jp112sdl/HB-UNI-Sen-PH-ORP/README.md

# HB-UNI-Sen-PH-ORP

universeller HomeMatic PH- + ORP-Sensor

#### Bauteile:

- Arduino Pro Mini (3.3V / 8MHz)
- CC1101 868MHz Funkmodul 
- PH Sensor https://www.dfrobot.com/product-1782.html
- ORP Sensor https://www.dfrobot.com/product-1071.html
- I2C LCD Display 2x16 
- DS18B20 Temperatursensor
- Widerstände: 240 Ohm, 4,7k

#### Schaltungsübersicht

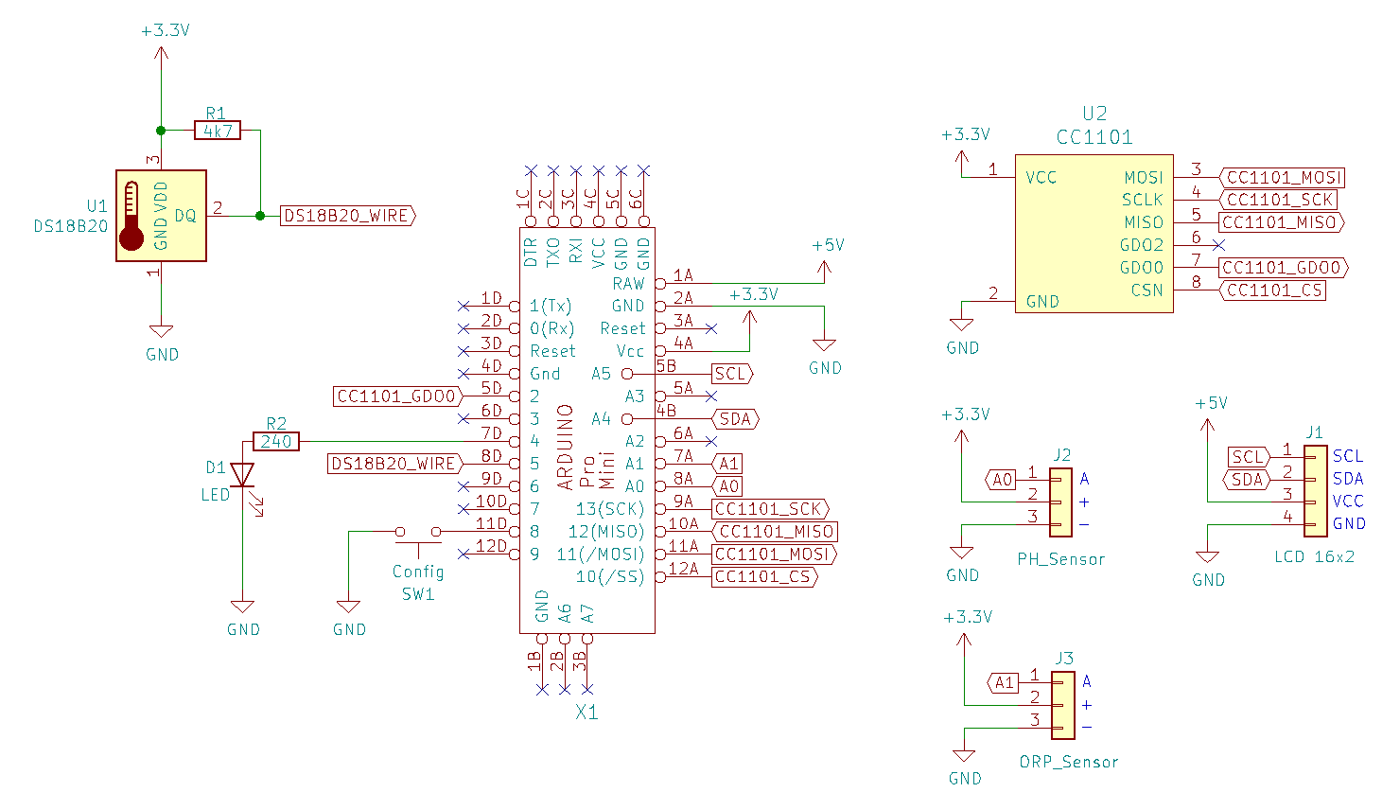
[picture p1: Images/schematics.png]
schematics


#### CCU Status und Bedienung

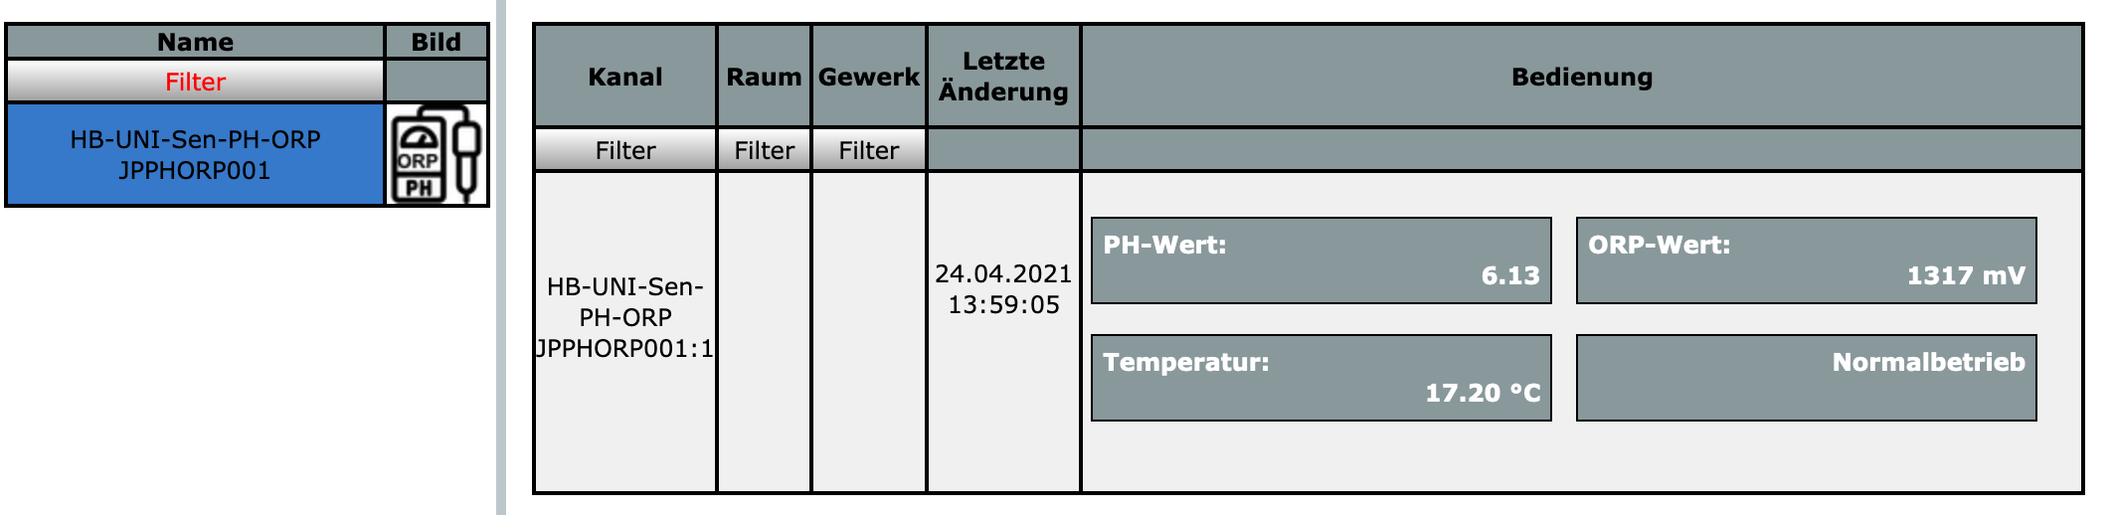
[picture p2: Images/ccu_bedienung.png]
bedienung


#### CCU Einstellungen

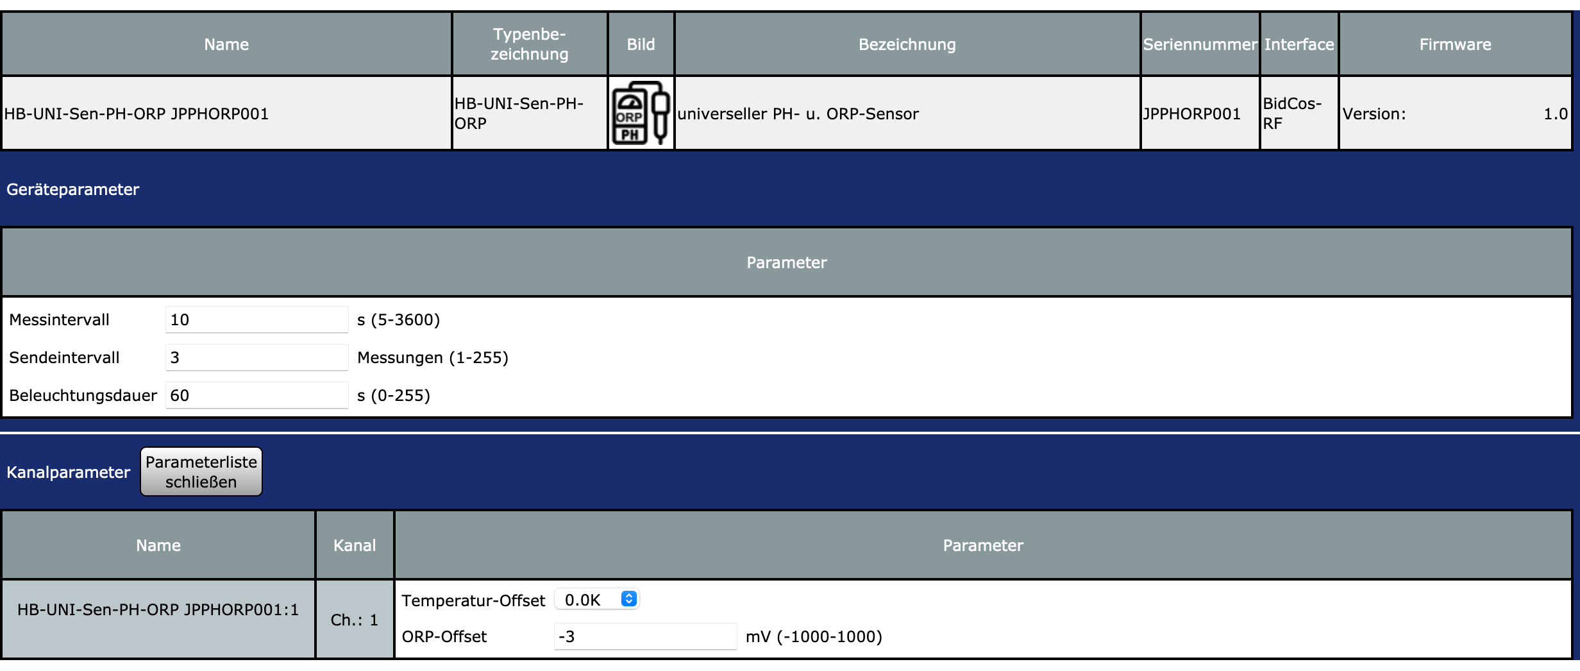
[picture p3: Images/ccu_einstellungen.png]
einstellungen


#### LCD Display
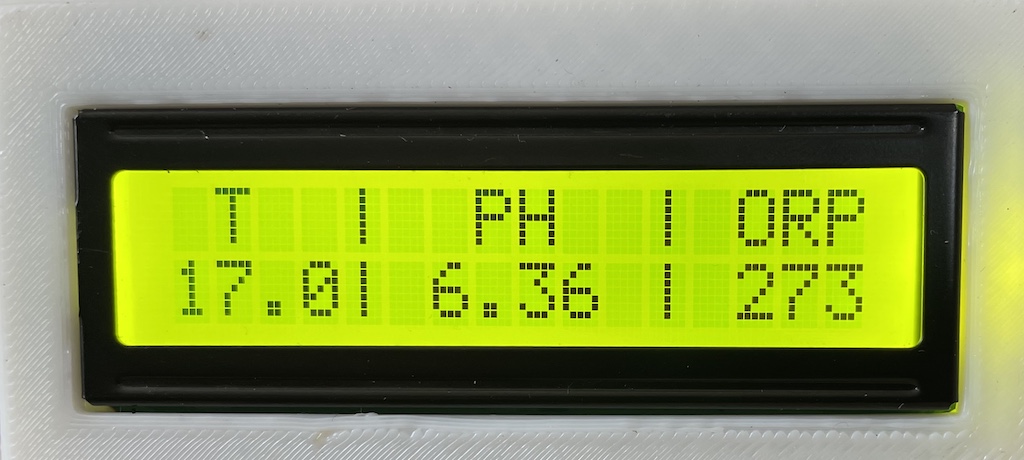
[picture p4: Images/IMG_2309.jpg]

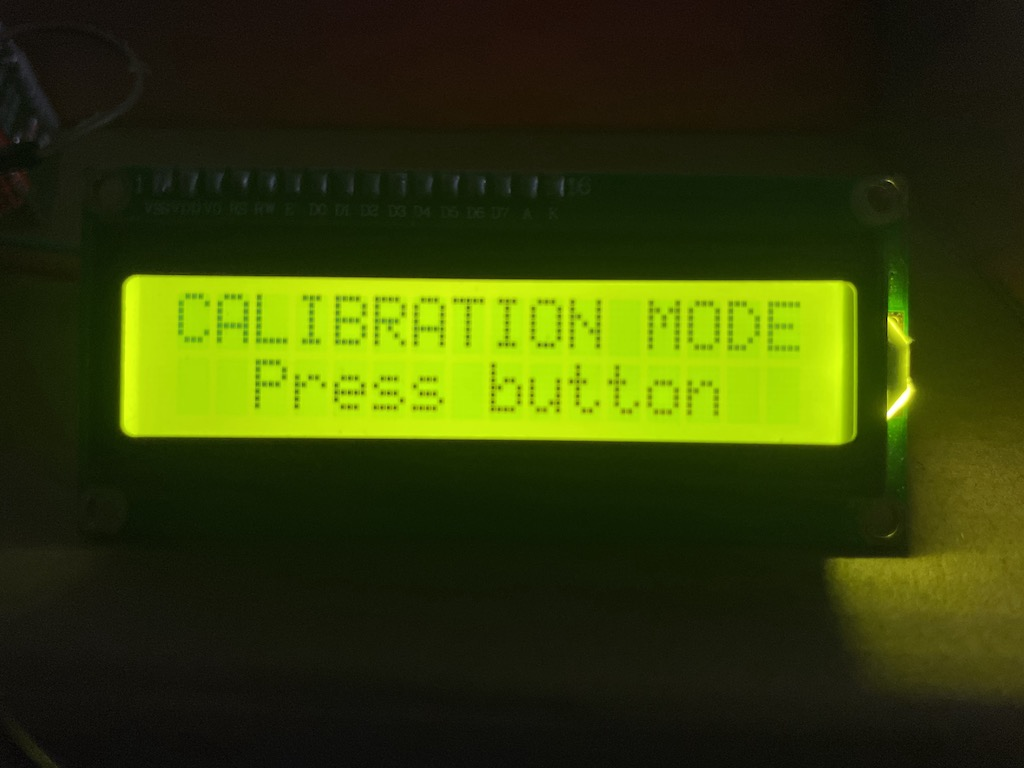
[picture p5: Images/IMG_2143.jpeg]

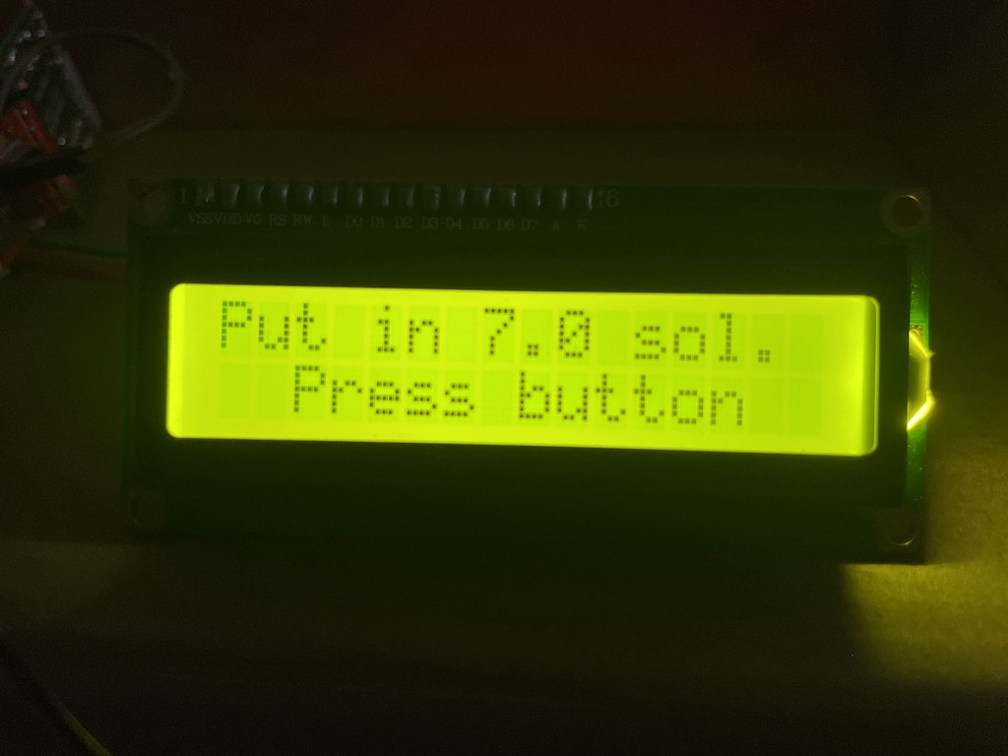
[picture p6: Images/IMG_2144.jpeg]
