jp112sdl/HB-UNI-Sen-PH-ORP/Docs/schematic/HB-UNI-Sen-PH-ORP.pdf

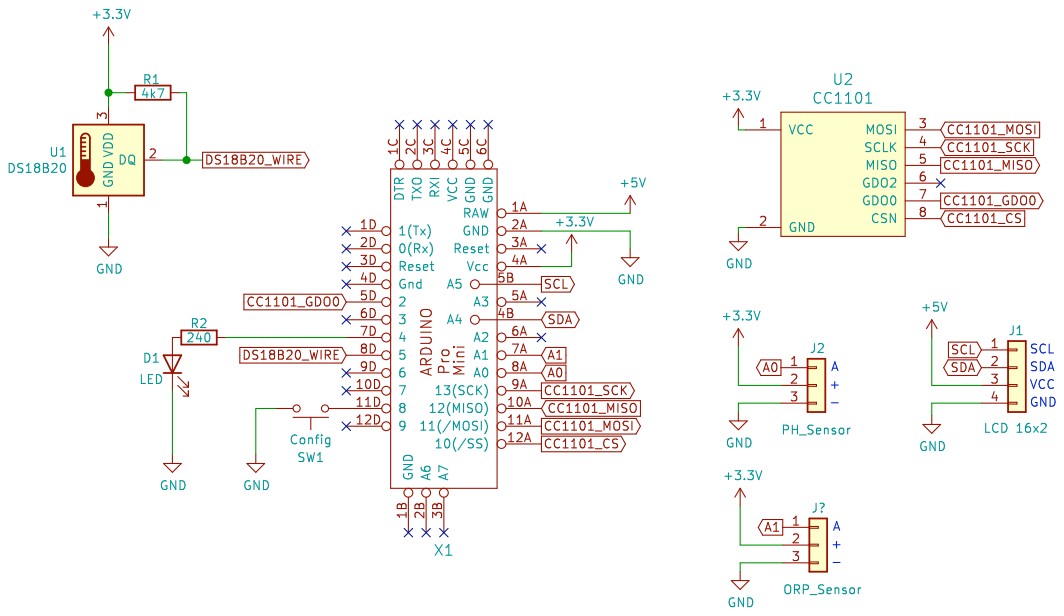
[picture p7: page 1]
